CMU-Robotics-Club/Red-Robot-2026/hardware/robot-board/haj-isometric.png

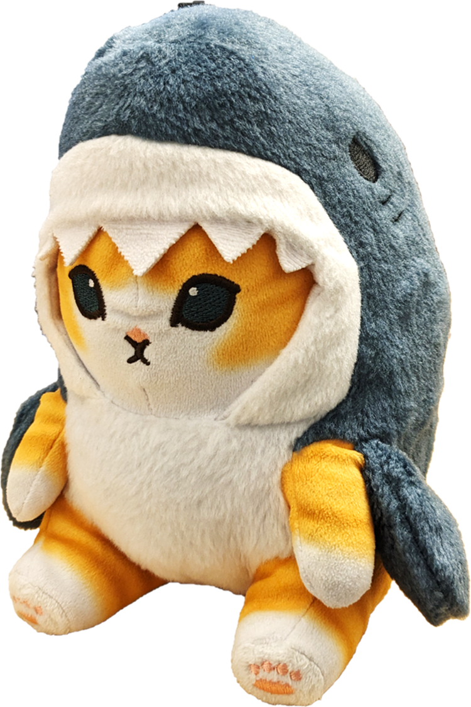
hardware/robot-board/haj-isometric.png
