CMU-Robotics-Club/Red-Robot-2026/hardware/robot-board/haj-frontfacing.png

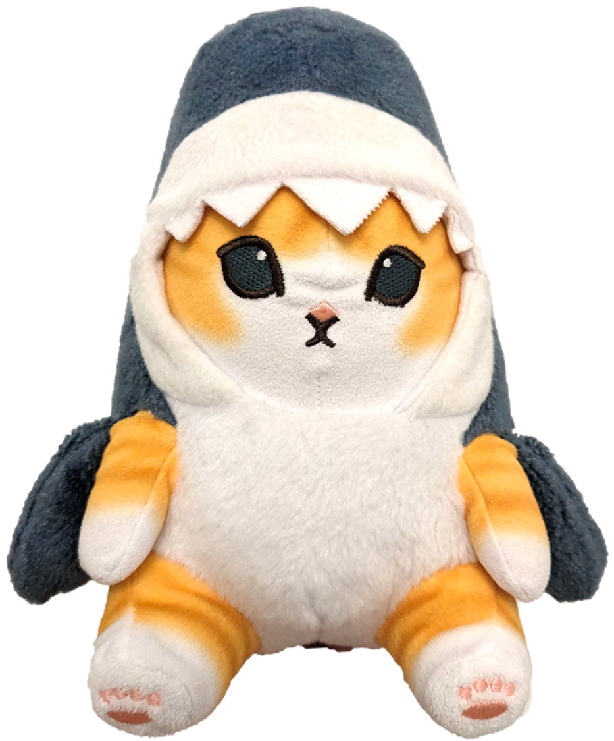
hardware/robot-board/haj-frontfacing.png
