CMU-Robotics-Club/Red-Robot-2026/hardware/robot-board/production/bom.csv

Designator | Footprint | Quantity | Value | LCSC Part #
BZ1 | MLT-7525 | 1 | Buzzer | C95299
C1, C2, C3, C4 | 1206 | 4 | 10uF | C33546013
C10, C9 | 0402 | 2 | 33pF | C107005
C11, C13 | 1206 | 2 | 47uF | C385907
C12, C14 | 1206 | 2 | 33uF | C342307
C15, C22, C27, C32, C35, C38, C39, C41 | 0805 | 8 | 10uF | C15850
C16, C17, C18 | CP_Elec_10x10 | 3 | 1000uF | C970714
C19, C20, C23, C24, C25, C28, C29, C30, C33, C34, C36, C43, C47, C5, C6, C7, C8 | 0402 | 17 | 0.1uF | C1525
C21, C26, C31, C40 | 0805 | 4 | 1uF | C282734
C37 | 0805 | 1 | 100uF | C141660
C42 | 0805 | 1 | 22uF | C296720
C44 | CP_Elec_8x10 | 1 | 1000uF | C2910470
C45 | 0402 | 1 | 1uF | C49210445
C46 | 0805 | 1 | 4.7uF | C880382
D1, D10 | D_SOD-123 | 2 | D_Small | C82544
D2 | 1206 | 1 | LBAT | C125086
D3 | 1206 | 1 | PLED | C51933322
D5 | 1206 | 1 | PWR | C5123493
D7 | 1206 | 1 | RXLED | C51933322
D9 | 1206 | 1 | BLED | C375460
F1 | Fuseholder_Littelfuse_Nano2_154x | 1 | Fuse_Small | C206916
J1 | PinHeader_1x09_P2.54mm_Vertical_SMD_Pin1Left | 1 | Conn_01x09_Pin | C49423356
J10, J11, J8, J9 | TerminalBlock_DB301V-3.5-2P-GN-H_1x02_P3.50mm_Horizontal | 4 | 1x2_Screw | C695629
J2 | BarrelJack_CLIFF_FC681465S_SMT_Horizontal | 1 | Barrel_Jack | C114916
J3 | USB_C_Receptacle_GCT_USB4105-xx-A_16P_TopMnt_Horizontal | 1 | USB_C_Receptacle_USB2.0_14P | C2988369
J4, J5, J6, J7 | PinHeader_1x03_P2.54mm_Vertical_SMD_Pin1Right | 4 | Conn_01x03_Pin | C5160786
L1 | L_Bourns_SRP7028A_7.3x6.6mm | 1 | 4.7uH | C51933838
L2 | L_Bourns_SRP7028A_7.3x6.6mm | 1 | 5.6uH | C5351382
Q1, Q2, Q3, Q4, Q5 | SOT-23 | 5 | BSS138 | C112239
R1 | 0402 | 1 | 10k | C25744
R10, R11, R12, R13, R14, R15, R8, R9 | 0402 | 8 | 4.7k | C105871
R16 | 0402 | 1 | 180R | C138045
R17, R18, R22, R44 | 0402 | 4 | 5.1k | C25905
R19, R20, R24, R29, R6, R7 | 0402 | 6 | 1k | C11702
R2, R26, R4 | 0603 | 3 | 100k | C122538
R21 | 0402 | 1 | 33k | C25779
R27 | 0603 | 1 | 33k | C705768
R3 | 0603 | 1 | 31.6k | C860829
R42, R43 | 0402 | 2 | 22R | C2929994
R5 | 0603 | 1 | 19.1k | C855669
SW1, SW2 | SW_Push_SPST_TS-1088 | 2 | SW_SPST | C720477
U1 | ESP32-S3-WROOM-1 | 1 | ESP32-S3-WROOM-1 | C2913197
U10 | SOIC-24W_7.5x15.4mm_P1.27mm | 1 | MAX7219 | C52476
U2, U3 | WSON-12-1EP_3x3mm_P0.5mm_EP1.5x2.5mm | 2 | LMR51450 | C5782413
U4 | D_SMB | 1 | SMBJ12A | C151251
U6, U7 | WSON-12-1EP_3x2mm_P0.5mm_EP1x2.65 | 2 | DRV8835 | C129328
U8 | XL-SA3391SRWC | 1 | XL-SA3391SRWC | C49652877
U9 | TSSOP-14_4.4x5mm_P0.65mm | 1 | 74ACT125 | C52940839
