CMU-Robotics-Club/Red-Robot-2026/hardware/robot-board/.step

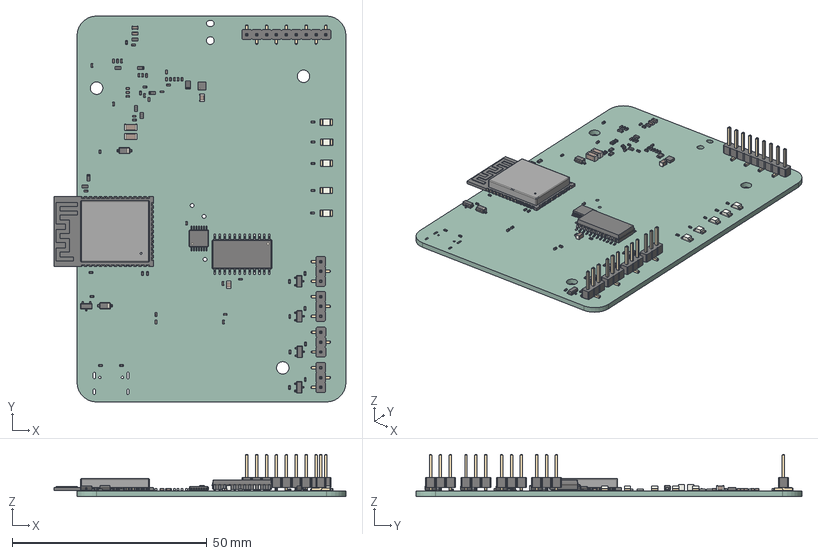
[picture p3: CAD file, 2026-09-28]
hardware/robot-board/.step
74.9 x 99.0 x 10.9 mm
R_0402_1005Metric x 25
C_0402_1005Metric x 30
R_0603_1608Metric x 8
SOIC-24W_7.5x15.4mm_P1.27mm
TSSOP-14_4.4x5mm_P0.65mm
SOT-23 x 5
R_0805_2012Metric
D_SOD-123 x 2
C_0603_1608Metric x 2
LED_1206_3216Metric x 5
PinHeader_1x03_P2.54mm_Vertical_SMD_Pin1Right x 4
PinHeader_1x09_P2.54mm_Vertical_SMD_Pin1Left
C_0805_2012Metric x 2
C_1206_3216Metric x 2
WSON-6-1EP_2x2mm_P0.65mm_EP1x1.6mm
ESP32-S3-WROOM-1
robot-board_PCB
