CMU-Robotics-Club/Red-Robot-2026/hardware/robot-board/robot-board.kicad_pcb

## KiCad design hardware/robot-board/robot-board.kicad_pcb (2026-10-20)

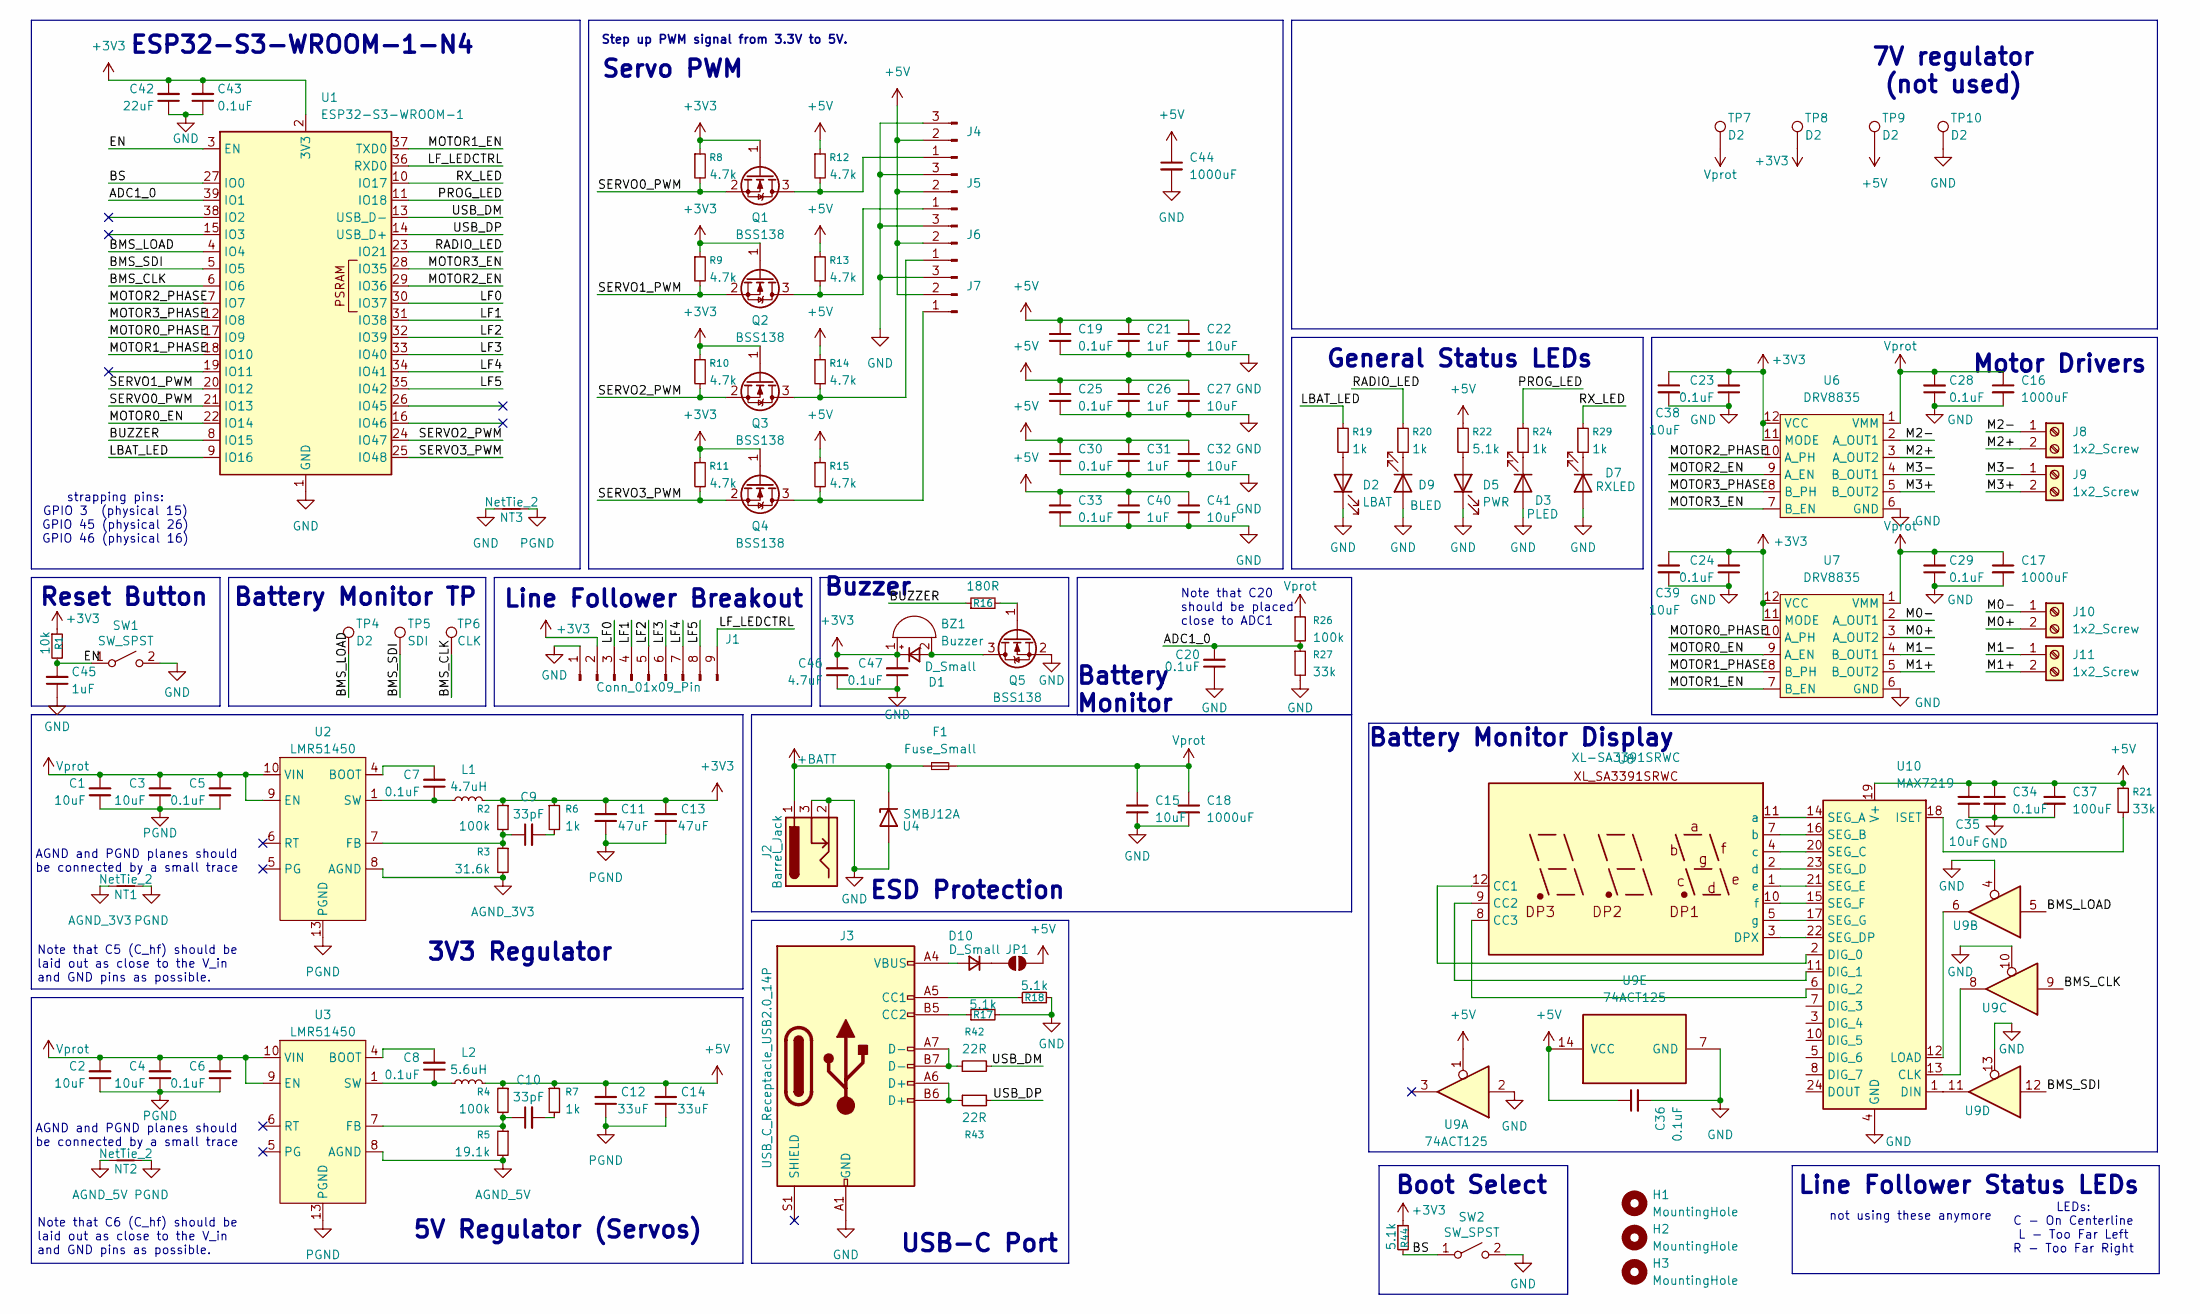
[picture p4: schematic robot-board.kicad_sch, Red Robot 26+ Mainboard]

Parts:
BZ1: Buzzer; MLT-7525; JLC P/N C95299
C1, C2, C3, C4: 10uF; C_1206_3216Metric; JLC P/N C33546013
C5, C6, C7, C8, C19, C20, C23, C24, C25, C28, C29, C30, C33, C34, C36, C43, C47: 0.1uF; C_0402_1005Metric; JLC P/N C1525
C9, C10: 33pF; C_0402_1005Metric; JLC P/N C107005
C11, C13: 47uF; C_1206_3216Metric; JLC P/N C385907
C12, C14: 33uF; C_1206_3216Metric; JLC P/N C342307
C15, C22, C27, C32, C35, C38, C39, C41: 10uF; C_0805_2012Metric; JLC P/N C15850
C16, C17, C18: 1000uF; CP_Elec_10x10; JLC P/N C970714
C21, C26, C31, C40: 1uF; C_0805_2012Metric; JLC P/N C282734
C37: 100uF; C_0805_2012Metric; JLC P/N C141660
C42: 22uF; C_0805_2012Metric; JLC P/N C296720
C44: 1000uF; CP_Elec_8x10; JLC P/N C2910470
C45: 1uF; C_0402_1005Metric; JLC P/N C49210445
C46: 4.7uF; C_0805_2012Metric; JLC P/N C880382
D1, D10: D_Small; D_SOD-123; JLC P/N C82544
D2: LBAT; LED_1206_3216Metric; JLC P/N C125086
D3: PLED; LED_1206_3216Metric; JLC P/N C51933322
D5: PWR; LED_1206_3216Metric; JLC P/N C5123493
D7: RXLED; LED_1206_3216Metric; JLC P/N C51933322
D9: BLED; LED_1206_3216Metric; JLC P/N C375460
F1: Fuse_Small; Fuseholder_Littelfuse_Nano2_154x; JLC P/N C206916
H1, H2, H3: MountingHole; MountingHole_3.2mm_M3
J1: Conn_01x09_Pin; PinHeader_1x09_P2.54mm_Vertical_SMD_Pin1Left; JLC P/N C49423356
J2: Barrel_Jack; BarrelJack_CLIFF_FC681465S_SMT_Horizontal; JLC P/N C114916
J3: USB_C_Receptacle_USB2.0_14P; USB_C_Receptacle_GCT_USB4105-xx-A_16P_TopMnt_Horizontal; JLC P/N C2988369
J4, J5, J6, J7: Conn_01x03_Pin; PinHeader_1x03_P2.54mm_Vertical_SMD_Pin1Right; JLC P/N C5160786
J8, J9, J10, J11: 1x2_Screw; TerminalBlock_DB301V-3.5-2P-GN-H_1x02_P3.50mm_Horizontal; JLC P/N C695629
JP1: SolderJumper_2_Open; SolderJumper-2_P1.3mm_Open_Pad1.0x1.5mm
L1: 4.7uH; L_Bourns_SRP7028A_7.3x6.6mm; JLC P/N C51933838
L2: 5.6uH; L_Bourns_SRP7028A_7.3x6.6mm; JLC P/N C5351382
NT1, NT2: NetTie_2; NetTie-2_SMD_Pad0.25mm
NT3: NetTie_2; NetTie-2_SMD_Pad0.5mm
Q1, Q2, Q3, Q4, Q5: BSS138; SOT-23; JLC P/N C112239
R1: 10k; R_0402_1005Metric; JLC P/N C25744
R2, R4, R26: 100k; R_0603_1608Metric; JLC P/N C122538
R3: 31.6k; R_0603_1608Metric; JLC P/N C860829
R5: 19.1k; R_0603_1608Metric; JLC P/N C855669
R6, R7, R19, R20, R24, R29: 1k; R_0402_1005Metric; JLC P/N C11702
R8, R9, R10, R11, R12, R13, R14, R15: 4.7k; R_0402_1005Metric; JLC P/N C105871
R16: 180R; R_0402_1005Metric; JLC P/N C138045
R17, R18, R22, R44: 5.1k; R_0402_1005Metric; JLC P/N C25905
R21: 33k; R_0402_1005Metric; JLC P/N C25779
R27: 33k; R_0603_1608Metric; JLC P/N C705768
R42, R43: 22R; R_0402_1005Metric; JLC P/N C2929994
SW1, SW2: SW_SPST; SW_Push_SPST_TS-1088; JLC P/N C720477
TP4, TP7, TP8, TP9, TP10: D2; TestPoint_THTPad_2.0x2.0mm_Drill1.0mm
TP5: SDI; TestPoint_THTPad_2.0x2.0mm_Drill1.0mm
TP6: CLK; TestPoint_THTPad_2.0x2.0mm_Drill1.0mm
U1: ESP32-S3-WROOM-1; JLC P/N C2913197
U2, U3: LMR51450; WSON-12-1EP_3x3mm_P0.5mm_EP1.5x2.5mm; JLC P/N C5782413
U4: SMBJ12A; D_SMB; JLC P/N C151251
U6, U7: DRV8835; WSON-12-1EP_3x2mm_P0.5mm_EP1x2.65; JLC P/N C129328
U8: XL-SA3391SRWC; JLC P/N C49652877
U9: 74ACT125; TSSOP-14_4.4x5mm_P0.65mm; JLC P/N C52940839
U10: MAX7219; SOIC-24W_7.5x15.4mm_P1.27mm; JLC P/N C52476

Connections:
+3V3: BZ1.1 (+), C11.2, C13.2, C23.2, C24.2, C38.1, C39.1, C42.2, C43.2, C46.2, C47.2, D1.1 (K), J1.2, L1.2, Q1.1 (G), Q2.1 (G), Q3.1 (G), Q4.1 (G), R1.1, R2.1, R6.1, R8.1, R9.1, R10.1, R11.1, R44.1, TP8.1 (1_1), U1.2 (3V3), U6.11 (MODE), U6.12 (VCC), U7.11 (MODE), U7.12 (VCC)
+5V: C12.2, C14.2, C19.1, C21.1, C22.1, C25.1, C26.1, C27.1, C30.1, C31.1, C32.1, C33.1, C34.1, C35.1, C36.1, C37.1, C40.1, C41.1, C44.1, J4.2, J5.2, J6.2, J7.2, JP1.2 (B), L2.2, R4.1, R7.1, R12.1, R13.1, R14.1, R15.1, R21.1, R22.1, TP9.1 (1_1), U9.1, U9.14 (VCC), U10.19 (V+)
+BATT: F1.1, J2.1, U4.1 (K)
/ADC1_0: C20.2, R26.2, R27.1, U1.39 (IO1)
/BMS_CLK: TP6.1 (1_1), U1.6 (IO6), U9.9
/BMS_LOAD: TP4.1 (1_1), U1.4 (IO4), U9.5
/BMS_SDI: TP5.1 (1_1), U1.5 (IO5), U9.12
/BS: R44.2, SW2.1 (A), U1.27 (IO0)
/BUZZER: R16.1, U1.8 (IO15)
/EN: C45.2, R1.2, SW1.1 (A), U1.3 (EN)
/LBAT_LED: R19.1, U1.9 (IO16)
/LF0: J1.3, U1.30 (IO37)
/LF1: J1.4, U1.31 (IO38)
/LF2: J1.5, U1.32 (IO39)
/LF3: J1.6, U1.33 (IO40)
/LF4: J1.7, U1.34 (IO41)
/LF5: J1.8, U1.35 (IO42)
/LF_LEDCTRL: J1.9, U1.36 (RXD0)
/M0+: J10.2, U7.3 (A_OUT2)
/M0-: J10.1, U7.2 (A_OUT1)
/M1+: J11.2, U7.5 (B_OUT2)
/M1-: J11.1, U7.4 (B_OUT1)
/M2+: J8.2, U6.3 (A_OUT2)
/M2-: J8.1, U6.2 (A_OUT1)
/M3+: J9.2, U6.5 (B_OUT2)
/M3-: J9.1, U6.4 (B_OUT1)
/MOTOR0_EN: U1.22 (IO14), U7.9 (A_EN)
/MOTOR0_PHASE: U1.17 (IO9), U7.10 (A_PH)
/MOTOR1_EN: U1.37 (TXD0), U7.7 (B_EN)
/MOTOR1_PHASE: U1.18 (IO10), U7.8 (B_PH)
/MOTOR2_EN: U1.29 (IO36), U6.9 (A_EN)
/MOTOR2_PHASE: U1.7 (IO7), U6.10 (A_PH)
/MOTOR3_EN: U1.28 (IO35), U6.7 (B_EN)
/MOTOR3_PHASE: U1.12 (IO8), U6.8 (B_PH)
/PROG_LED: R24.1, U1.11 (IO18)
/RADIO_LED: R20.1, U1.23 (IO21)
/RX_LED: R29.1, U1.10 (IO17)
/SERVO0_PWM: Q1.2 (S), R8.2, U1.21 (IO13)
/SERVO1_PWM: Q2.2 (S), R9.2, U1.20 (IO12)
/SERVO2_PWM: Q3.2 (S), R10.2, U1.24 (IO47)
/SERVO3_PWM: Q4.2 (S), R11.2, U1.25 (IO48)
/USB_DM: R42.2, U1.13 (USB_D-)
/USB_DP: R43.2, U1.14 (USB_D+)
AGND_3V3: NT1.1, R3.2, U2.8 (AGND)
AGND_5V: NT2.1, R5.2, U3.8 (AGND)
GND: C15.2, C16.2, C17.2, C18.2, C19.2, C20.1, C21.2, C22.2, C23.1, C24.1, C25.2, C26.2, C27.2, C28.1, C29.1, C30.2, C31.2, C32.2, C33.2, C34.2, C35.2, C36.2, C37.2, C38.2, C39.2, C40.2, C41.2, C42.1, C43.1, C44.2, C45.1, C46.1, C47.1, D2.1 (K), D3.2 (A), D5.1 (K), D7.2 (A), D9.2 (A), J1.1, J2.2, J2.3, J3.A1 (GND), J3.A12 (GND), J3.B1 (GND), J3.B12 (GND), J4.3, J5.3, J6.3, J7.3, NT3.1, Q5.2 (S), R17.2, R18.2, R27.2, SW1.2 (B), SW2.2 (B), TP10.1 (1_1), U1.1 (GND), U1.40 (GND), U1.41 (GND), U4.2 (A), U6.6 (GND), U6.13 (GND), U7.6 (GND), U7.13 (GND), U9.2, U9.4, U9.7 (GND), U9.10, U9.13, U10.4 (GND), U10.9 (GND)
unnamed: BZ1.2 (-), D1.2 (A), Q5.3 (D)
unnamed: C7.1, L1.1, U2.1 (SW), U2.2 (SW), U2.3 (SW)
unnamed: C8.1, L2.1, U3.1 (SW), U3.2 (SW), U3.3 (SW)
unnamed: C9.2, R6.2
unnamed: C10.2, R7.2
unnamed: D2.2 (A), R19.2
unnamed: D3.1 (K), R24.2
unnamed: D5.2 (A), R22.2
unnamed: D7.1 (K), R29.2
unnamed: D9.1 (K), R20.2
unnamed: D10.2 (A), J3.A4 (VBUS), J3.A9 (VBUS), J3.B4 (VBUS), J3.B9 (VBUS)
unnamed: D10.1 (K), JP1.1 (A)
unnamed: J3.A5 (CC1), R18.1
unnamed: J3.B5 (CC2), R17.1
unnamed: J3.A6 (D+), J3.B6 (D+), R43.1
unnamed: J3.A7 (D-), J3.B7 (D-), R42.1
unnamed: J4.1, Q1.3 (D), R12.2
unnamed: J5.1, Q2.3 (D), R13.2
unnamed: J6.1, Q3.3 (D), R14.2
unnamed: J7.1, Q4.3 (D), R15.2
unnamed: Q5.1 (G), R16.2
unnamed: C7.2, U2.4 (BOOT)
unnamed: C9.1, R2.2, R3.1, U2.7 (FB)
unnamed: C8.2, U3.4 (BOOT)
unnamed: C10.1, R4.2, R5.1, U3.7 (FB)
unnamed: U9.8, U10.13 (CLK)
unnamed: U8.12 (CC1), U10.2 (DIG_0)
unnamed: U8.9 (CC2), U10.11 (DIG_1)
unnamed: U8.8 (CC3), U10.6 (DIG_2)
unnamed: U9.11, U10.1 (DIN)
unnamed: R21.2, U10.18 (ISET)
unnamed: U9.6, U10.12 (LOAD)
unnamed: U8.11 (a), U10.14 (SEG_A)
unnamed: U8.7 (b), U10.16 (SEG_B)
unnamed: U8.4 (c), U10.20 (SEG_C)
unnamed: U8.2 (d), U10.23 (SEG_D)
unnamed: U8.3 (DPX), U10.22 (SEG_DP)
unnamed: U8.1 (e), U10.21 (SEG_E)
unnamed: U8.10 (f), U10.15 (SEG_F)
unnamed: U8.5 (g), U10.17 (SEG_G)
PGND: C1.1, C2.1, C3.1, C4.1, C5.1, C6.1, C11.1, C12.1, C13.1, C14.1, NT1.2, NT2.2, NT3.2, U2.13 (PGND), U3.13 (PGND)
Vprot: C1.2, C2.2, C3.2, C4.2, C5.2, C6.2, C15.1, C16.1, C17.1, C18.1, C28.2, C29.2, F1.2, R26.1, TP7.1 (1_1), U2.9 (EN), U2.10 (VIN), U2.11 (VIN), U2.12 (VIN), U3.9 (EN), U3.10 (VIN), U3.11 (VIN), U3.12 (VIN), U6.1 (VMM), U7.1 (VMM)

Notes on the sheet:
Line Follower Status LEDs
Battery Monitor
ESD Protection
Boot Select
Motor Drivers
Note that C20 should be placed close to ADC1
Reset Button
3V3 Regulator
Battery Monitor Display
Servo PWM
Note that C5 (C_hf) should be laid out as close to the V_in and GND pins as possible.
AGND and PGND planes should be connected by a small trace
not using these anymore
ESP32-S3-WROOM-1-N4
Note that C6 (C_hf) should be laid out as close to the V_in and GND pins as possible.
strapping pins: GPIO 3 (physical 15) GPIO 45 (physical 26) GPIO 46 (physical 16)
Battery Monitor TP
5V Regulator (Servos)
Line Follower Breakout
Step up PWM signal from 3.3V to 5V.
Buzzer
USB-C Port
General Status LEDs
LEDs: C - On Centerline L - Too Far Left R - Too Far Right
7V regulator (not used)

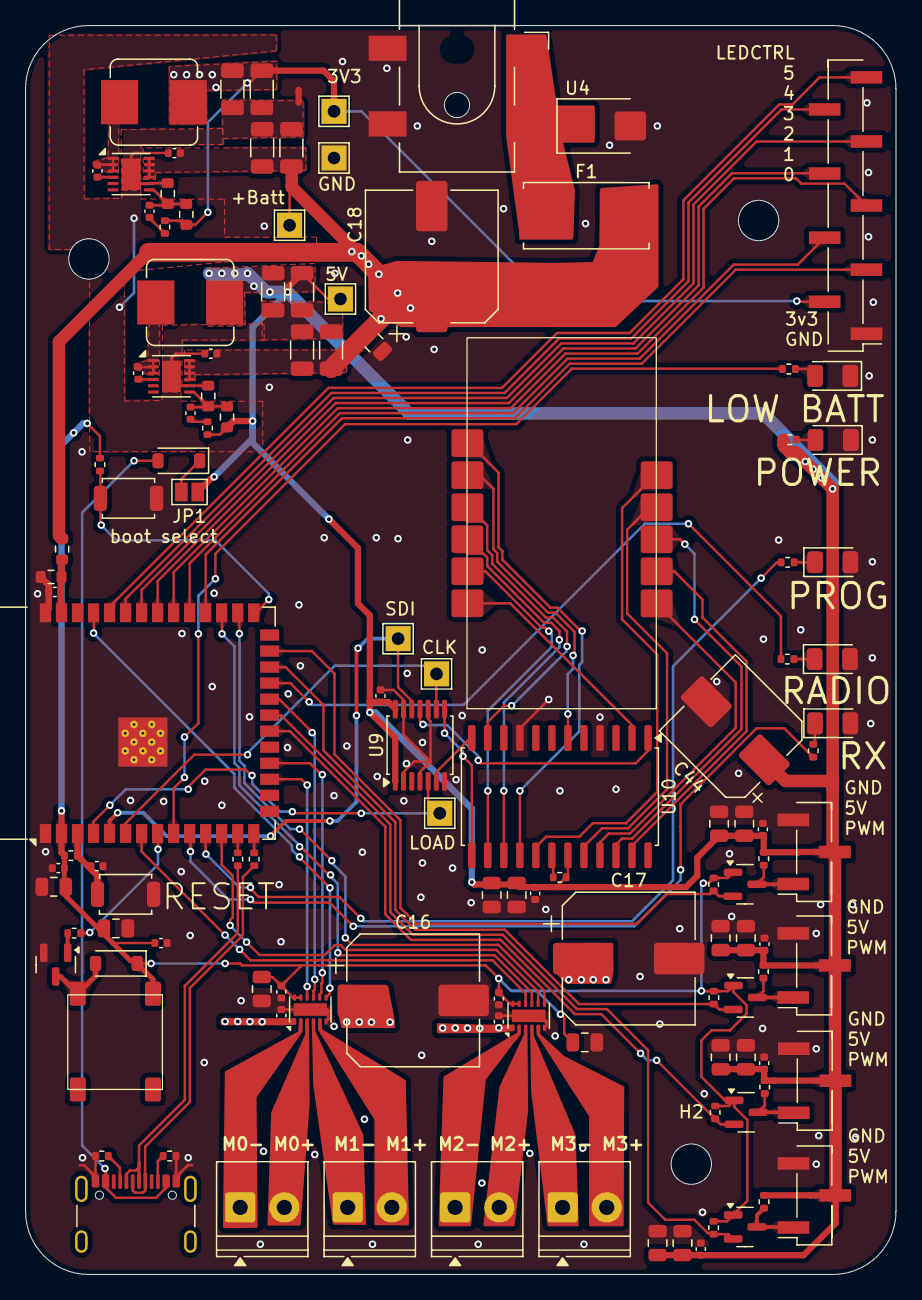
[picture p5: board robot-board.kicad_pcb from above]

Board: 4 copper layers, 69.0 x 99.0 mm, 128 parts (0 on the bottom side), 88 nets.
