CMU-Robotics-Club/Red-Robot-2026/hardware/line-sensor/line-sensor.kicad_pcb

## KiCad design hardware/line-sensor/line-sensor.kicad_pcb (2026-03-20)

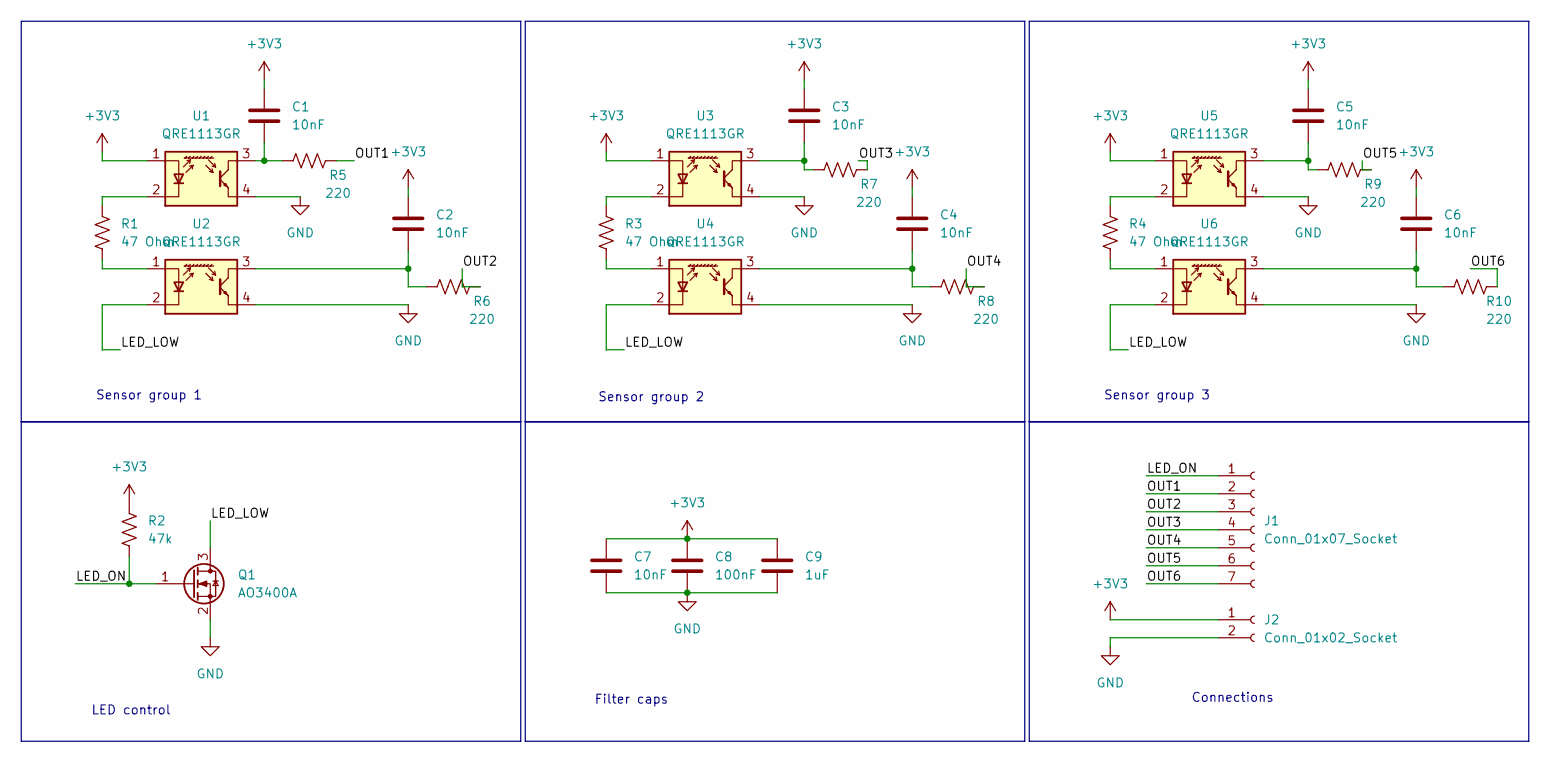
[picture p6: schematic line-sensor.kicad_sch]

Parts:
C1, C2, C3, C4, C5, C6, C7: 10nF; C_0603_1608Metric_Pad1.08x0.95mm_HandSolder
C8: 100nF; C_0603_1608Metric_Pad1.08x0.95mm_HandSolder
C9: 1uF; C_0603_1608Metric_Pad1.08x0.95mm_HandSolder
J1: Conn_01x07_Socket; PinHeader_1x07_P2.54mm_Vertical_SMD_Pin1Left; LCSC C42379199
J2: Conn_01x02_Socket; PinSocket_1x02_P2.54mm_Vertical_SMD_Pin1Right; LCSC C42381025
Q1: AO3400A; SOT-23; LCSC C20917
R1, R3, R4: 47 Ohm; R_0603_1608Metric_Pad0.98x0.95mm_HandSolder
R2: 47k; R_0603_1608Metric_Pad0.98x0.95mm_HandSolder
R5, R6, R7, R8, R9, R10: 220; R_0603_1608Metric_Pad0.98x0.95mm_HandSolder
U1, U2, U3, U4, U5, U6: QRE1113GR; OnSemi_CASE100CY; LCSC C232862

Connections:
+3V3: C1.1, C2.1, C3.1, C4.1, C5.1, C6.1, C7.1, C8.1, C9.1, J2.1, R2.1, U1.1 (A), U3.1 (A), U5.1 (A)
/LED_LOW: Q1.3 (D), U2.2 (K), U4.2 (K), U6.2 (K)
/LED_ON: J1.1, Q1.1 (G), R2.2
/OUT1: J1.2, R5.2
/OUT2: J1.3, R6.2
/OUT3: J1.4, R7.2
/OUT4: J1.5, R8.2
/OUT5: J1.6, R9.2
/OUT6: J1.7, R10.2
GND: C7.2, C8.2, C9.2, J2.2, Q1.2 (S), U1.4, U2.4, U3.4, U4.4, U5.4, U6.4
unnamed: C1.2, R5.1, U1.3
unnamed: C2.2, R6.1, U2.3
unnamed: C3.2, R7.1, U3.3
unnamed: C4.2, R8.1, U4.3
unnamed: C5.2, R9.1, U5.3
unnamed: C6.2, R10.1, U6.3
unnamed: R1.1, U1.2 (K)
unnamed: R1.2, U2.1 (A)
unnamed: R3.1, U3.2 (K)
unnamed: R3.2, U4.1 (A)
unnamed: R4.1, U5.2 (K)
unnamed: R4.2, U6.1 (A)

Notes on the sheet:
Sensor group 2
Sensor group 3
Filter caps
LED control
Sensor group 1
Connections

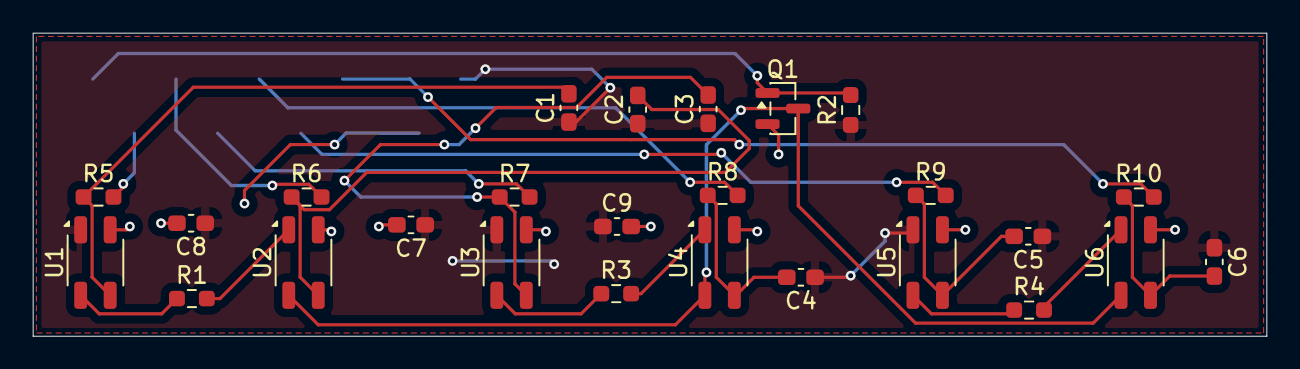
[picture p7: board line-sensor.kicad_pcb from above]

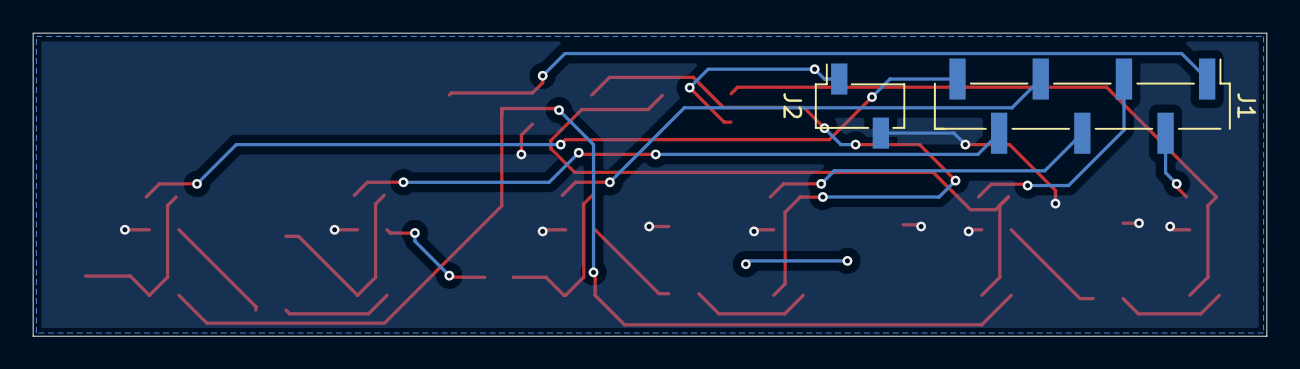
[picture p8: board line-sensor.kicad_pcb from below]

Board: 2 copper layers, 75.3 x 18.5 mm, 28 parts (2 on the bottom side), 22 nets.
