CMU-Robotics-Club/Red-Robot-2026/Red-Robot/include/pinouts.h

// 7 Segment Battery Monitor Shift Register
#define BATMON_LATCH 12
#define BATMON_CLK 11
#define BATMON_DATA 14

// 7 Segment Battery Monitor Digit Select (common-anode enable via Q6/Q7/Q8)
#define BMS_D0 2
#define BMS_D1 3
#define BMS_D2 4
