CMU-Robotics-Club/Red-Robot-2026/(commit log)

2026-01-18 created robot pcb project file
    and added symbol and footprint for esp
    [robot-board.kicad_pcb, robot-board.kicad_sch]
2026-01-22 repo cleanup: added gitignore
    * deleted symbol files for esp module (they're auto-included with kicad
    libraries)
    * deleted backup files from last commit
2026-01-22 added "outline" for robot pcb
    [robot-board.kicad_sch]
2026-01-30 many changes
    power management, status lights, servo control, BMS (waiting for mithun), ESD protection
    [robot-board.kicad_sch]
2026-01-31 added folder for code, set up pio
    * pio configured for ESP32-S3-Devkit
    * WIP code for controlling 7 segment display via shift register
    * tested, currently not functional. maybe the extra time delays will
    help
2026-02-04 initial line sensor schematic
    [line-sensor.kicad_pcb, line-sensor.kicad_sch]
2026-02-04 added power conn
    [line-sensor.kicad_sch]
2026-02-04 added LCSC part number to schematic
    [line-sensor.kicad_sch]
2026-02-06 finished most of schematic
    [robot-board.kicad_sch]
2026-02-06 fixed a bunch of bs
    [robot-board.kicad_sch]
2026-02-06 schematic basically done
    [robot-board.csv, robot-board.kicad_sch]
2026-02-06 BOM and changed footprints
    [bom-jlc.csv, robot-board.csv, robot-board.kicad_sch]
2026-02-06 Added schematic for 7 segment display
    [7segdisplay.kicad_sch]
2026-02-06 Placed 7segdisplay in the correct folder, fuck you Matthew
    [7segdisplay.kicad_sch]
2026-02-06 bnyahaj
    bnyahaj
    [robot-board.kicad_sch]
2026-02-17 Inserted the new 7 segment display wiring to be later added to the full pcb design
2026-02-17 Fixed 7segmentdisplay sch file to include version 1 and 2a and 2b
    [7segdisplay.kicad_sch]
2026-02-20 fixed 7seg
    [robot-board.kicad_sch]
2026-02-23 JLCPCB BOM and P&P files (default ones didnt work)
    [line-sensor.csv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]
2026-02-23 Not sure why this wasn't committed
    [line-sensor.kicad_pcb, line-sensor.kicad_sch]
2026-03-12 added buzzer, battery LCD, etc
    [robot-board.kicad_sch]
2026-03-20 fixed some stuff
    [robot-board.kicad_pcb, robot-board.kicad_sch]
2026-03-20 who up roboing their club
    [robot-board.kicad_pcb, robot-board.kicad_sch]
2026-03-20 uhhh i hope this works, delaynie
    [line-sensor.kicad_pcb]
2026-03-23 gerbers n stuff hi hi
    [bom-jlc.csv, placement-jlc.csv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]
2026-04-13 fixed the thingies
    [bom-jlc.csv, placement-jlc.csv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]
2026-04-23 fixed footprint/part mismatch
    [robot-board.kicad_sch]
2026-06-29 fixed all issues, removed LF LEDs
    [robot-board.kicad_pcb, robot-board.kicad_sch]
2026-09-02 changed display driver
    [robot-board.kicad_pcb, robot-board.kicad_sch]
2026-09-04 should be final
    [robot-board.kicad_pcb, robot-board.kicad_sch]
2026-09-05 gerbers final
    [robot-board-B_Cu.gbr, robot-board-B_Mask.gbr, robot-board-B_Paste.gbr, robot-board-B_Silkscreen.gbr, robot-board-Edge_Cuts.gbr, robot-board-F_Cu.gbr, robot-board-F_Mask.gbr, robot-board-F_Paste.gbr]
2026-09-28 forgot to commit holes my b
    [.step, bom-jlc.csv, placement-jlc.csv, robot-board.csv, robot-board.kicad_pcb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]
2026-10-03 motor polygons and silkscreen labels
    [robot-board.kicad_pcb]
2026-10-03 should be all changes made except motor connectors
    [robot-board.kicad_pcb, robot-board.kicad_sch]
2026-10-03 zone fill fixed
    [robot-board.kicad_pcb]
2026-10-04 most changes done
    [robot-board.kicad_pcb, robot-board.kicad_sch]
2026-10-06 should be final changes
    [robot-board.kicad_pcb, robot-board.kicad_sch]
2026-10-07 fixed fuse holder
    [robot-board.kicad_pcb, robot-board.kicad_sch]
2026-10-10 changed to screw terminals
    [robot-board.kicad_pcb, robot-board.kicad_sch]
2026-10-10 small spacing changes, renamed motor lines
    [robot-board.kicad_pcb, robot-board.kicad_sch]
2026-10-14 fixed motor polygon clearances
2026-10-16 added more GND vias
2026-10-16 changed silkscreen thickness
2026-10-17 updated mfg files; setting to subtract soldermask from silkscreen
2026-10-17 updated bom; added screw terminal JLC part #
2026-10-18 shifted switch down; all pads on board
2026-10-18 swapped out-of-stock capacitors
2026-10-18 changed and documented LED colors; updated mfg/output files
2026-10-20 moved 5V line to back
2026-10-20 changed GND font thickness; final export
